1tsMS/advanced_sli_BE_Project_2026_2027/docs/literature_survey.md

# Literature Survey

Add the full survey here: for each paper, a short summary and how it relates to this project. The
references section of the [README](../README.md) lists three papers cited at the start of the project;
expand each one below.

| # | Paper | Summary | Relevance to Advanced SLI |
|---|---|---|---|
| 1 | Junqi Li, Qing Dong, "A Development Method for Load Adaptive Matching Digital Twin System of Bridge Cranes" | *To be filled in* | *To be filled in* |
| 2 | Dae-Ho Jang, Gi-Tae Roh, "Simulation-Based Optimization of Crane Lifting Position and Capacity Using a Construction Digital Twin for Prefabricated Bridge Deck Assembly" | *To be filled in* | *To be filled in* |
| 3 | Yihai Fang, Yong K. Cho, "A Framework for Real-time Pro-active Safety Assistance for Mobile Crane Lifting Operations" | *To be filled in* | *To be filled in* |

## Gaps identified

Summarise, from the survey, what existing Safe Load Indicator (SLI) and rated-capacity-indicator
systems do, and where they fall short for small, low-capacity, truck-mounted cranes — the gap this
project addresses (see the Problem Statement and Existing System sections of the README).
