1tsMS/advanced_sli_BE_Project_2026_2027/images/images.md

# Images

| File | Used in | Description |
|---|---|---|
| `system_architecture.png` | [README.md](../README.md) (System Architecture, Flowchart / Algorithm) | Control-flow diagram of the SLI safety logic: read sensors, load-chart lookup, alarm escalation, IMU-based sway check, logging |

## Missing (to add later, per the README)

- `circuit_diagram.png` — a drawn circuit diagram. The pin-by-pin wiring is documented instead in [hardware/connections.md](../hardware/connections.md).
- `prototype_photo.jpg` and other result images/videos — to be added once hardware testing is complete (see the README's *Result Images / Videos* section).
