1tsMS/advanced_sli_BE_Project_2026_2027/docs/review1_post_proposal_feedback.pdf

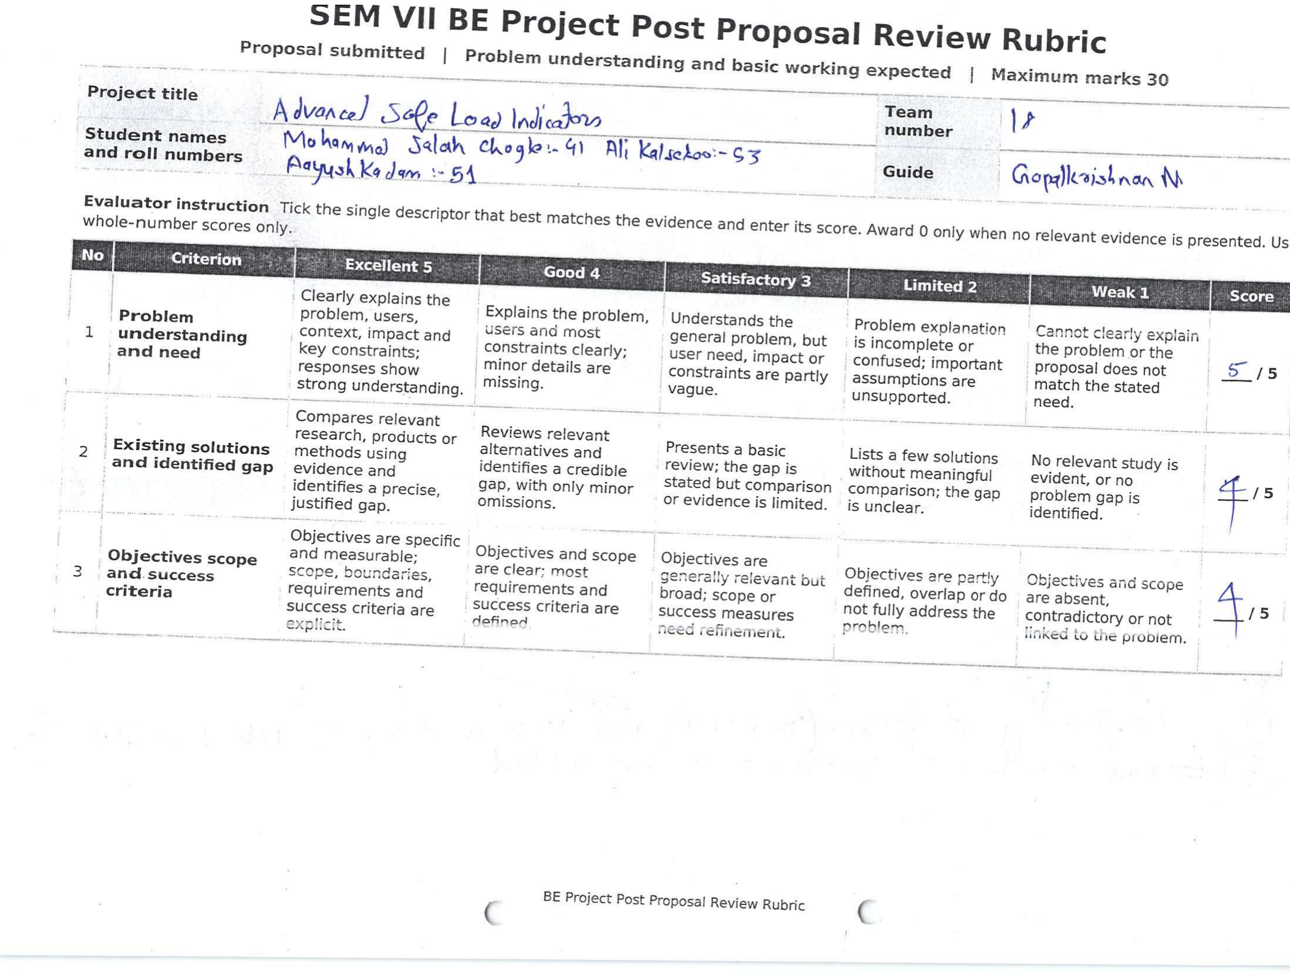
[picture p15: page 1]
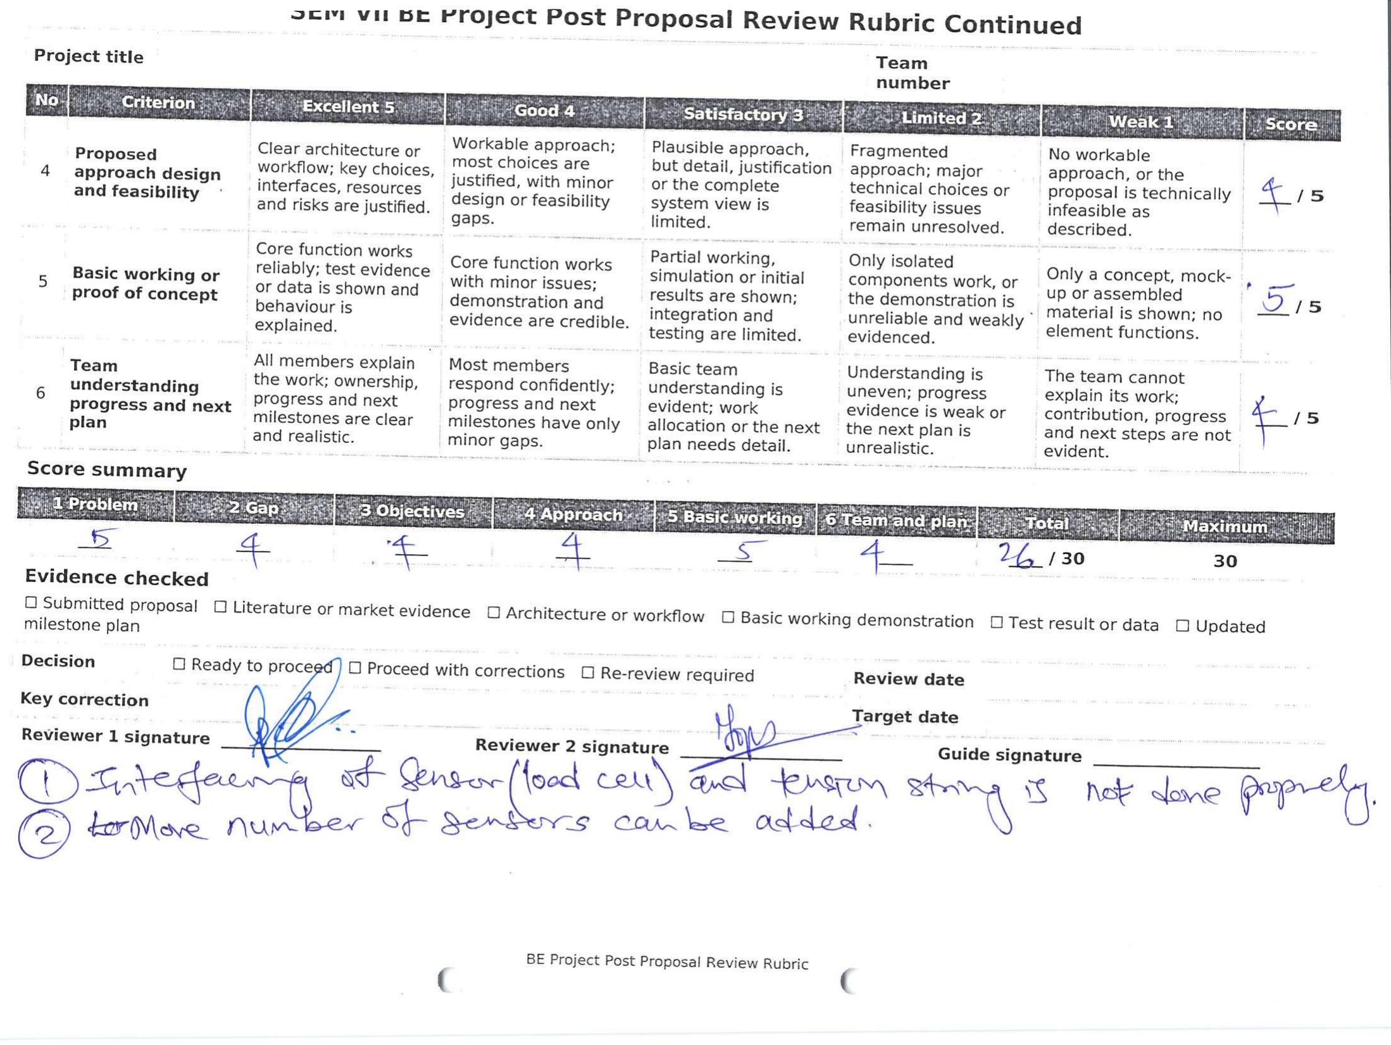
[picture p16: page 2]
