1tsMS/advanced_sli_BE_Project_2026_2027/docs/review2_evaluation_feedback.pdf

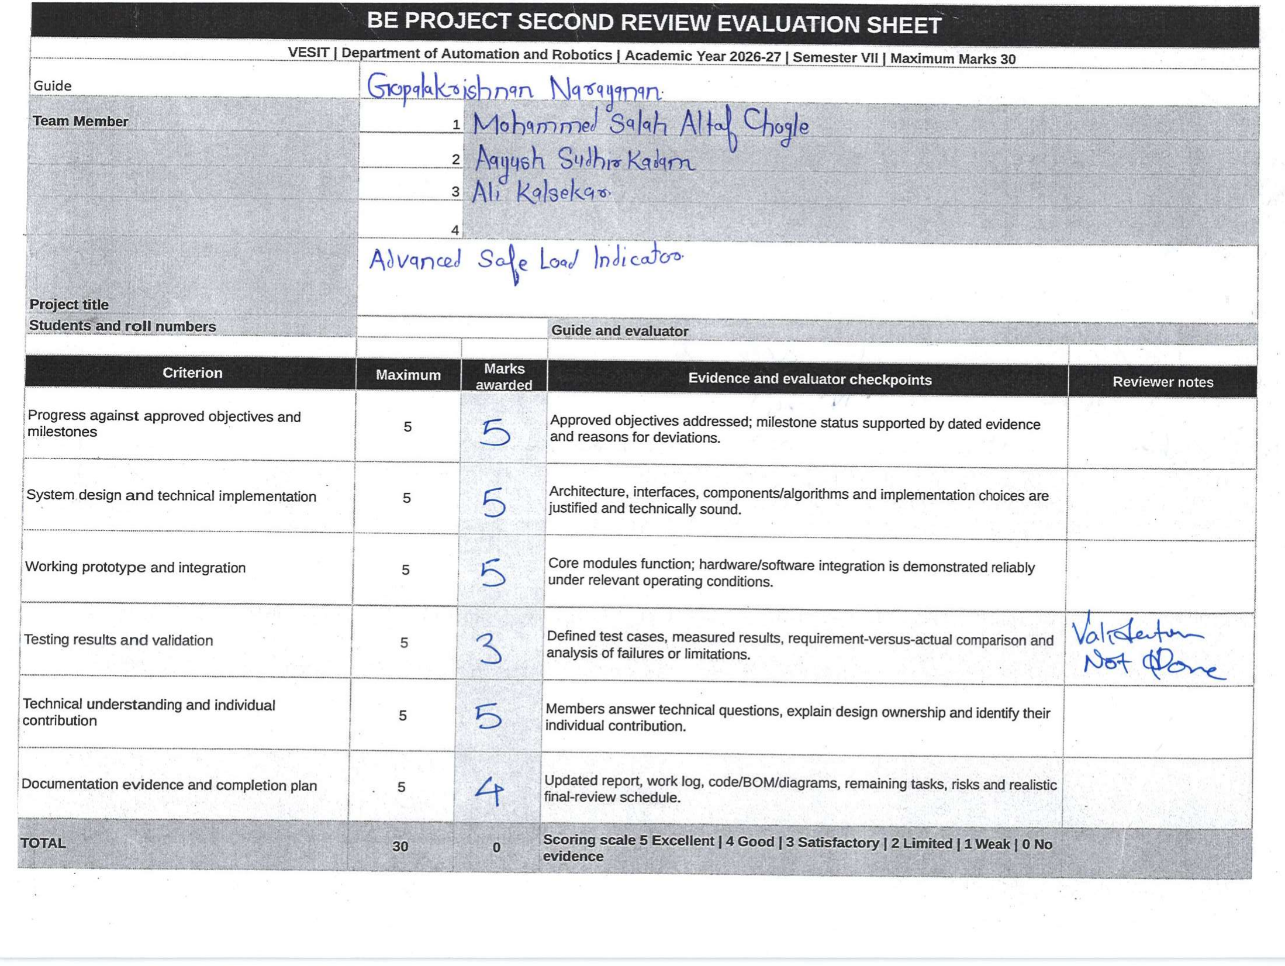
[picture p17: page 1]
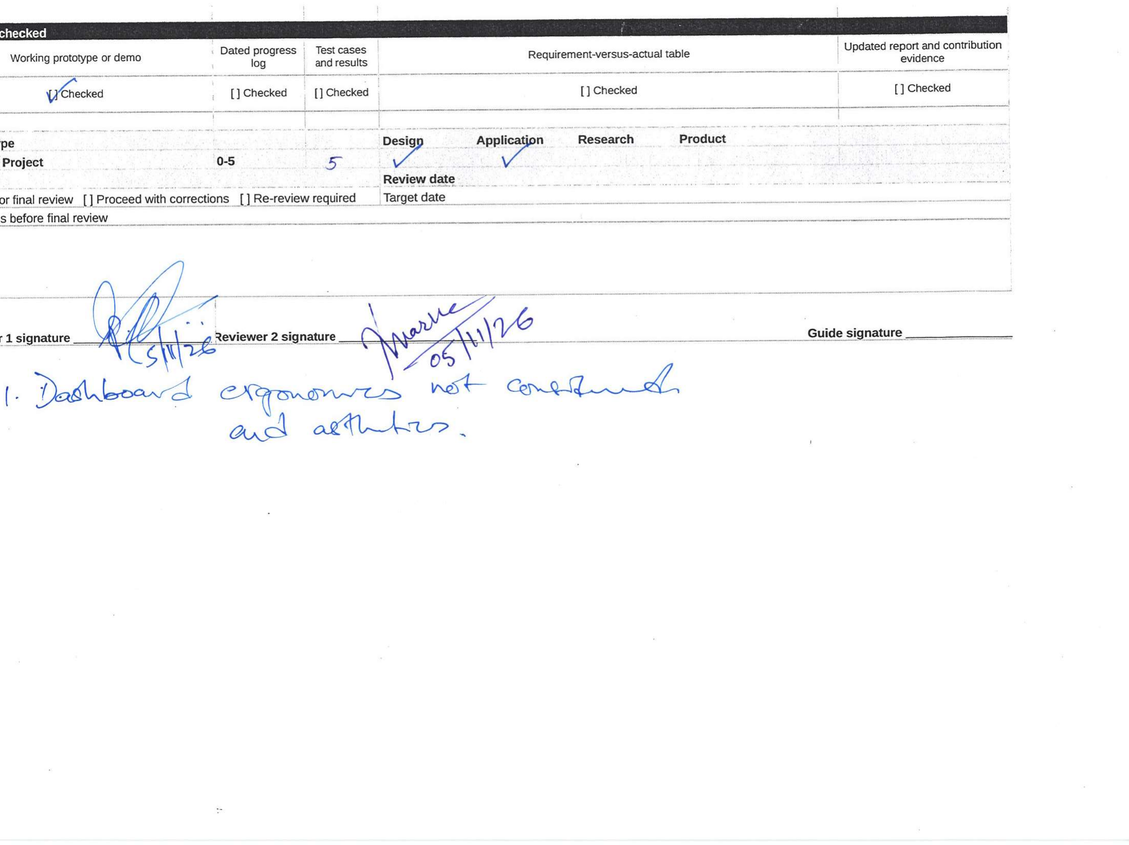
[picture p18: page 2]
