1tsMS/advanced_sli_BE_Project_2026_2027/software/firmware/esp32_mainv2/command_task.cpp

// ============================================================
//  Command Task — Implementation
// ============================================================
#include "command_task.h"
#include "telemetry_task.h"
#include "sensor_task.h"
#include "serial_out.h"
#include "persist.h"
#include "safety_task.h"
#include "shaper_math.h"
#include "esp_task_wdt.h"

// Reset reason string, set in setup() (shown in DBG)
extern const char* g_resetReason;

// Subsystem references (set by init)
static MegaBridge*   _mega      = nullptr;
static N20Encoder*   _winch     = nullptr;
static HX711Driver*  _loadCell  = nullptr;
static MPU6050Driver* _imu      = nullptr;
static AS5600Driver* _teleEnc   = nullptr;
static AS5600Driver* _swingEnc  = nullptr;
static AS5600Driver* _boomEnc   = nullptr;

// Global sensor data — declared in esp32_main.ino
extern SensorData sensorData;

/** The winch ignores the speed value: any S > 0 runs it at WINCH_PWM (config.h).
 *  Scaled PWM was too weak to turn the geared N20 + drum at low slider settings. */
static inline uint8_t winchPwm(uint16_t speed) {
    return speed > 0 ? (uint8_t)WINCH_PWM : 0;
}

/** Hand a calibration step to SensorTask (core 1, owner of the buses). */
static void queueCal(CalCommand type, uint8_t axis, float value, int8_t flag) {
    CalRequest req;
    req.type  = type;
    req.axis  = axis;
    req.value = value;
    req.flag  = flag;
    if (!sensorTask_requestCal(req)) serialLine("$ACK,CAL%u,ERR,BUSY", (unsigned)type);
}

// Winch dead-man: the dashboard repeats a held M4 command every 100 ms.
// If nothing arrives for MOTION_TIMEOUT_MS the winch is stopped (link lost,
// browser frozen, button release missed). The Mega does the same for M1-M3.
static bool          _winchActive    = false;
static unsigned long _lastWinchCmdMs = 0;

// ---- SLI enforcement ----
// What each axis (1-4) was last told to do, so a motion that becomes blocked
// while it runs can be stopped. Expires with the dead-man timeout, like the
// motor itself.
struct ActiveMotion {
    bool          moving;
    uint8_t       dir;
    unsigned long lastMs;
};
static ActiveMotion _motion[5] = {};     // index = axis, 0 unused
static uint8_t      _refusedDir[5];      // last refused dir per axis (+1), 0 = none: ACK once per episode

// ---- Swing input shaping (the shaper itself runs on the Mega) ----
static bool          _shapeOn       = false;
static float         _shapeLenOvr   = 0.0f;   // mm, 0 = from the hook drop
static uint16_t      _shapeSentMs   = 0;      // T/2 last sent to the Mega
static float         _shapeLenMm    = 0.0f;
static unsigned long _shapeLastTxMs = 0;

/** Keep the Mega's T/2 in step with the hook drop; resend now and then in case it reset. */
static void shaperTick(bool force) {
    if (!_shapeOn || !_mega) return;
    float hookDrop = NAN;
    if (xSemaphoreTake(sensorMutex, pdMS_TO_TICKS(2)) == pdTRUE) {
        hookDrop = sensorData.hookDropMM;
        xSemaphoreGive(sensorMutex);
    }
    const float    L    = shaper_lengthMm(hookDrop, _shapeLenOvr, SHAPER_LOAD_CG_MM,
                                          SHAPER_L_MIN_MM, SHAPER_L_MAX_MM);
    const uint16_t half = shaper_halfPeriodMs(L);
    const unsigned long now = millis();
    const bool changed = abs((int)half - (int)_shapeSentMs) >= 10;
    if (!force && !changed && now - _shapeLastTxMs < SHAPER_RESEND_MS) return;
    char line[16];
    snprintf(line, sizeof(line), "I1 P%u", (unsigned)half);
    _mega->sendRaw(line);
    _shapeLastTxMs = now;
    _shapeLenMm    = L;
    if (force || changed) serialLine("$SHP,1,%.0f,%u", L, (unsigned)half);
    _shapeSentMs = half;
}

/**
 * graceful = the operator let go: a shaped swing then decelerates in two
 * halves (M0 A1 G1). SLI cuts, refusals and E-stop always stop instantly.
 */
static void stopAxis(uint8_t axis, bool graceful = false) {
    if (axis == 4) {
        if (_winch) _winch->stopMotor();
        _winchActive = false;
    } else if (_mega) {
        if (graceful && axis == 1 && _shapeOn) {
            _mega->sendRaw("M0 A1 G1");
        } else {
            MotorCommand stop = {};
            stop.axis     = 0;
            stop.stopAxis = axis;
            _mega->sendMotorCommand(stop);
        }
    }
    _motion[axis].moving = false;
}

/** Stop every axis that is moving in a direction the SLI no longer allows. */
static void enforceSafety() {
    const unsigned long now = millis();
    for (uint8_t a = 1; a <= 4; a++) {
        ActiveMotion& m = _motion[a];
        if (!m.moving) continue;
        if (now - m.lastMs > MOTION_TIMEOUT_MS) { m.moving = false; continue; }   // dead-man already stopped it
        const char* why;
        if (!safety_motionAllowed(a, m.dir, &why)) {
            stopAxis(a);
            _refusedDir[a] = m.dir + 1;
            serialLine("$ACK,SLI,CUT,A%u,D%u,%s", a, m.dir, why);
        }
    }
}

void commandTask_init(
    MegaBridge* mega,
    N20Encoder* winch,
    HX711Driver* loadCell,
    MPU6050Driver* imu,
    AS5600Driver* teleEnc,
    AS5600Driver* swingEnc,
    AS5600Driver* boomEnc
) {
    _mega     = mega;
    _winch    = winch;
    _loadCell = loadCell;
    _imu      = imu;
    _teleEnc  = teleEnc;
    _swingEnc = swingEnc;
    _boomEnc  = boomEnc;
}

/** Called from the UART driver's event task whenever bytes arrive (Serial.onReceive). */
void commandTask_onSerialRx() {
    if (g_commandTask) xTaskNotifyGive(g_commandTask);
}

static uint32_t stackFree(TaskHandle_t t) {
    return t ? (uint32_t)uxTaskGetStackHighWaterMark(t) : 0;   // bytes on ESP-IDF
}

void commandTask(void* pvParameters) {
    GCodeParser parser;
    char lineBuffer[128];
    int lineIdx = 0;

    esp_task_wdt_add(NULL);

    for (;;) {
        // Event-driven: sleep until the UART reports input, or at most
        // COMMAND_IDLE_WAKE_MS so the winch dead-man is still checked.
        ulTaskNotifyTake(pdTRUE, pdMS_TO_TICKS(COMMAND_IDLE_WAKE_MS));
        esp_task_wdt_reset();

        // Read characters from USB Serial until we get a full line
        while (Serial.available()) {
            char c = Serial.read();

            if (c == '\n' || c == '\r') {
                if (lineIdx == 0) continue;  // Skip empty lines

                lineBuffer[lineIdx] = '\0';  // Null-terminate
                lineIdx = 0;

                // Parse the G-code line
                ParsedCommand cmd;
                ParseResult result = parser.parse(lineBuffer, &cmd);

                if (result != PARSE_OK) continue;

                // Dispatch based on command type
                switch (cmd.type) {

                    case CMD_ESTOP: {
                        // Emergency stop ALL motors, then latch: nothing moves until RST
                        if (_mega)  _mega->sendMotorCommand(cmd.motor);
                        if (_winch) _winch->stopMotor();
                        _winchActive = false;
                        for (uint8_t a = 1; a <= 4; a++) _motion[a].moving = false;
                        safety_estop();          // SafetyTask reports alarmLevel 3 while latched
                        serialLine("$ACK,ESTOP");
                        break;
                    }

                    case CMD_MOTOR: {
                        const uint8_t axis = cmd.motor.axis;
                        if (cmd.motor.speed == 0) {          // S0 = stop, always allowed
                            stopAxis(axis, true);
                            break;
                        }
                        const char* why;
                        if (!safety_motionAllowed(axis, cmd.motor.direction, &why)) {
                            // Held buttons repeat every 100 ms: stop + ACK once per episode
                            if (_motion[axis].moving || _refusedDir[axis] != cmd.motor.direction + 1) {
                                stopAxis(axis);
                                _refusedDir[axis] = cmd.motor.direction + 1;
                                serialLine("$ACK,SLI,REFUSED,A%u,D%u,%s", axis, cmd.motor.direction, why);
                            }
                            break;
                        }
                        _refusedDir[axis] = 0;
                        _motion[axis].moving = true;
                        _motion[axis].dir    = cmd.motor.direction;
                        _motion[axis].lastMs = millis();

                        if (cmd.motor.axis == 4) {
                            // Winch — handled directly by ESP32 DRV8833
                            if (_winch) {
                                const uint8_t pwm = winchPwm(cmd.motor.speed);
                                _winch->setMotor(pwm, cmd.motor.direction);
                                _winchActive    = (pwm > 0);
                                _lastWinchCmdMs = millis();
                            }
                        } else {
                            // Axes 1-3 (Swing, Lift, Tele) → forward to Mega
                            if (_mega) _mega->sendMotorCommand(cmd.motor);
                        }
                        break;
                    }

                    case CMD_STOP_AXIS: {
                        if (cmd.motor.stopAxis >= 1 && cmd.motor.stopAxis <= 4) {
                            _motion[cmd.motor.stopAxis].moving = false;
                            _refusedDir[cmd.motor.stopAxis]    = 0;
                        }
                        if (cmd.motor.stopAxis == 4) {
                            // Stop winch locally
                            if (_winch) _winch->stopMotor();
                            _winchActive = false;
                        } else if (cmd.motor.stopAxis == 1 && _shapeOn) {
                            stopAxis(1, true);   // operator release: shaped
                        } else {
                            // Stop stepper axis on Mega
                            if (_mega) _mega->sendMotorCommand(cmd.motor);
                        }
                        break;
                    }

                    case CMD_SHAPE: {
                        if (cmd.shapeOn) {
                            _shapeOn     = true;
                            _shapeLenOvr = cmd.shapeLenMm;
                            shaperTick(true);   // sends I1 P.. and $SHP
                        } else {
                            _shapeOn = false;
                            if (_mega) _mega->sendRaw("I0");
                            _motion[1].moving = false;   // the Mega stops the swing on I0
                            serialLine("$SHP,0,0,0");
                        }
                        break;
                    }

                    case CMD_CALIBRATE: {
                        switch (cmd.calType) {
                            // Everything that touches a sensor runs on core 1 (SensorTask),
                            // which sends the $ACK when done. The command core never
                            // blocks here, so a T0 is never stuck behind a calibration.
                            case CAL_TARE_LOAD:
                                queueCal(CAL_TARE_LOAD, 0, 0.0f, -1);
                                break;
                            case CAL_ZERO_IMU:
                                sensorTask_requestIMUCalibration(
                                    (uint8_t)cmd.boomAxis,
                                    (cmd.boomInv != 0),
                                    (uint8_t)cmd.tiltAxis,
                                    (cmd.tiltInv != 0)
                                );
                                break;
                            case CAL_RESET_TELE:
                                queueCal(CAL_RESET_TELE, ENC_TELE, cmd.teleScale, cmd.teleInvert);
                                break;
                            case CAL_ENC_REF:
                                queueCal(CAL_ENC_REF, cmd.encAxis, cmd.encValue, -1);
                                break;
                            case CAL_ENC_INVERT:
                                queueCal(CAL_ENC_INVERT, cmd.encAxis, 0.0f, cmd.encInvert);
                                break;
                            case CAL_ROPE_SCALE:
                                queueCal(CAL_ROPE_SCALE, CAL_AXIS_ROPE, cmd.encValue, -1);
                                break;
                            case CAL_LOAD:
                                queueCal(CAL_LOAD, cmd.calSub, cmd.encValue, -1);
                                break;
                            case CAL_AXIS_SCALE:
                                queueCal(CAL_AXIS_SCALE, cmd.encAxis, cmd.encValue, cmd.encInvert);
                                break;
                        }
                        break;
                    }

                    case CMD_DEBUG: {
                        // Send I2C scan + sensor status report
                        // Only cached flags and SensorTask's diagnostics are used here:
                        // probing the buses from this core would collide with SensorTask.
                        TelemetryFormatter fmt;
                        char dbgBuf[1536];
                        uint16_t fsrVals[4] = {0};
                        if (xSemaphoreTake(sensorMutex, pdMS_TO_TICKS(5)) == pdTRUE) {
                            memcpy(fsrVals, sensorData.fsr, sizeof(fsrVals));
                            xSemaphoreGive(sensorMutex);
                        }
                        SensorDiag diag;
                        sensorTask_getDiag(&diag, true);
                        RtosDiag rtos;
                        rtos.stackFree[0] = stackFree(g_sensorTask);
                        rtos.stackFree[1] = stackFree(g_hwBusTask);
                        rtos.stackFree[2] = stackFree(xTaskGetCurrentTaskHandle());
                        rtos.stackFree[3] = stackFree(g_serialTxTask);
                        rtos.stackFree[4] = stackFree(g_storageTask);
                        rtos.txDropped    = serialOut_dropped();
                        rtos.nvsWrites    = persist_writes();
                        rtos.nvsFailures  = persist_failures();
                        rtos.heapFree     = ESP.getFreeHeap();
                        rtos.resetReason  = g_resetReason;
                        fmt.formatDebugReport(
                            _imu      ? _imu->isConnected()      : false,
                            _loadCell ? _loadCell->isConnected()  : false,
                            fsrVals,
                            _winch ? _winch->getCount() : 0,
                            diag, rtos,
                            dbgBuf, sizeof(dbgBuf)
                        );
                        // Queued line by line for SerialTxTask; may wait briefly for
                        // space (this is not a real-time task), never prints directly
                        serialOut_sendBlock(dbgBuf, pdMS_TO_TICKS(5));
                        break;
                    }

                    case CMD_CONFIG: {
                        telemetryTask_setRate(cmd.configRate);
                        serialLine("$ACK,CFG,RATE,%u", (unsigned)cmd.configRate);
                        break;
                    }

                    case CMD_LOADCHART:
                        safety_handleLc(cmd.args);
                        break;

                    case CMD_SLI:
                        if (cmd.sliOff) {
                            safety_off();
                            serialLine("$ACK,SLI,OFF");
                        } else if (cmd.bypassS > 0) {
                            safety_bypass(cmd.bypassS);
                            serialLine("$ACK,SLI,BYPASS,%u", (unsigned)cmd.bypassS);
                        } else {
                            safety_arm();
                            serialLine("$ACK,SLI,ARMED");
                        }
                        break;

                    case CMD_RESET:
                        safety_reset();
                        serialLine("$ACK,RST");
                        break;

                    default:
                        break;
                }
            } else {
                // Buffer the character (prevent overflow)
                if (lineIdx < (int)(sizeof(lineBuffer) - 1)) {
                    lineBuffer[lineIdx++] = c;
                }
            }
        }

        // SLI: stop motions that became blocked while running (SafetyTask
        // notifies on every newly blocked direction; this also runs every 20 ms)
        enforceSafety();

        // Swing shaper period follows the hook drop (winch / telescope change it)
        shaperTick(false);

        // Winch dead-man
        if (_winchActive && (millis() - _lastWinchCmdMs) > MOTION_TIMEOUT_MS) {
            if (_winch) _winch->stopMotor();
            _winchActive = false;
            serialLine("$ACK,WATCHDOG,WINCH_STOPPED");
        }
    }
}
