1tsMS/advanced_sli_BE_Project_2026_2027/software/firmware/esp32_main/mega_bridge.cpp

// ============================================================
//  Mega Bridge — Implementation
// ============================================================
#include "mega_bridge.h"
#include <stdio.h>

void MegaBridge::begin(HardwareSerial* serial) {
    _megaSerial = serial;
    _megaSerial->begin(MEGA_BAUD, SERIAL_8N1, MEGA_RX_PIN, MEGA_TX_PIN);
    _connected = true;
}

void MegaBridge::sendReset() {
    if (!_megaSerial || !_connected) return;
    _megaSerial->println("RST");
}

void MegaBridge::sendMotorCommand(const MotorCommand& cmd) {
    if (!_megaSerial || !_connected) return;

    char line[32];

    // Emergency stop → forward immediately
    if (cmd.isEstop) {
        _megaSerial->println("T0");
        return;
    }

    // Only forward stepper axes (1=Swing, 2=Lift, 3=Tele) to Mega
    // Axis 4 (Winch) is driven directly by ESP32's DRV8833
    if (cmd.axis >= 1 && cmd.axis <= 3) {
        snprintf(line, sizeof(line), "M%u S%u D%u",
                 cmd.axis, cmd.speed, cmd.direction);
        _megaSerial->println(line);
    }

    // Stop axis command
    if (cmd.axis == 0 && cmd.stopAxis >= 1 && cmd.stopAxis <= 3) {
        snprintf(line, sizeof(line), "M0 A%u", cmd.stopAxis);
        _megaSerial->println(line);
    }
}
