1tsMS/advanced_sli_BE_Project_2026_2027/software/test_codes/hx_711_test/hx_711_test.ino

#include "HX711.h"

#define DT 16
#define SCK 17

HX711 scale;

void setup() {
  Serial.begin(115200);

  scale.begin(DT, SCK);

  Serial.println("HX711 test");
}

void loop() {
  if (scale.is_ready()) {
    long value = scale.read();
    Serial.println(value);
  } else {
    Serial.println("NOT READY");
  }

  delay(500);
}
